nathanJarvis/RichArduino/Presentation/RichArduino.pptx

## RichArduino

By Jack Hyde, Nathan Jarvis, Dean Choi, Jabari Booker

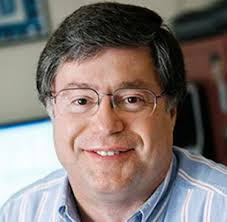
[picture p1: figure]
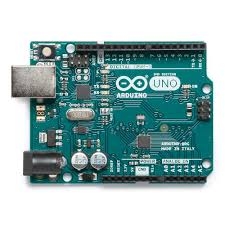
[picture p2: figure]

“

”

## Life Cycle of Program

“SMOP”

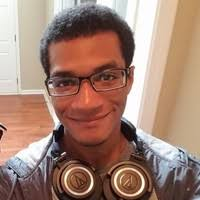
[picture p3: figure]

Compile

Assemble

Execute

.source

.asm

.bin

## Program Flow

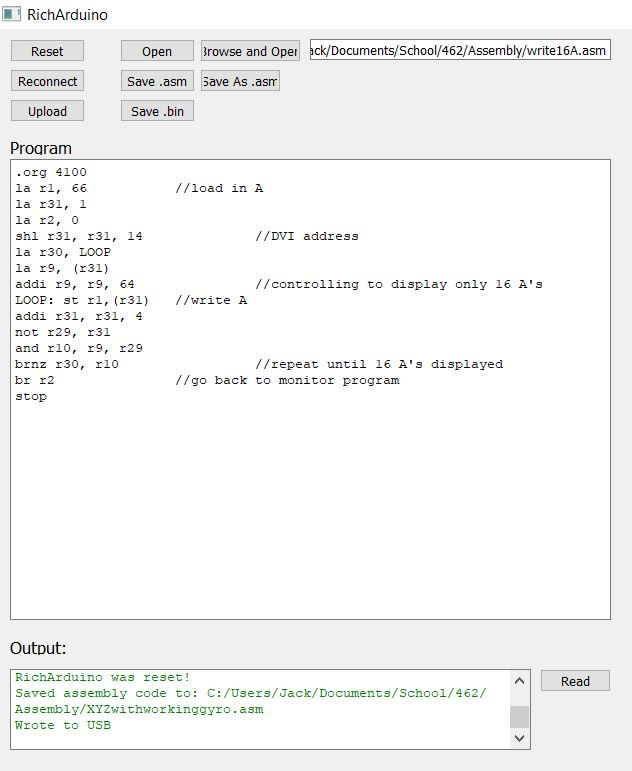
[picture p4: figure]
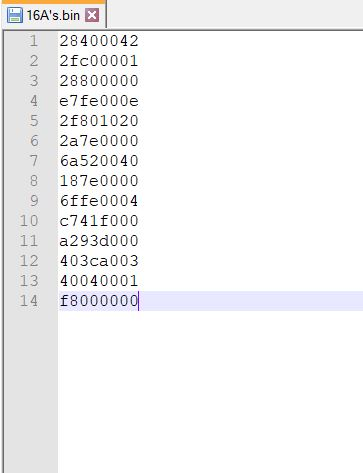
[picture p5: figure]

lots of work

Notes: When we actually run upload, prepends length and appends branch to address 0 which is the monitor program (more on this later)

## Slide 4

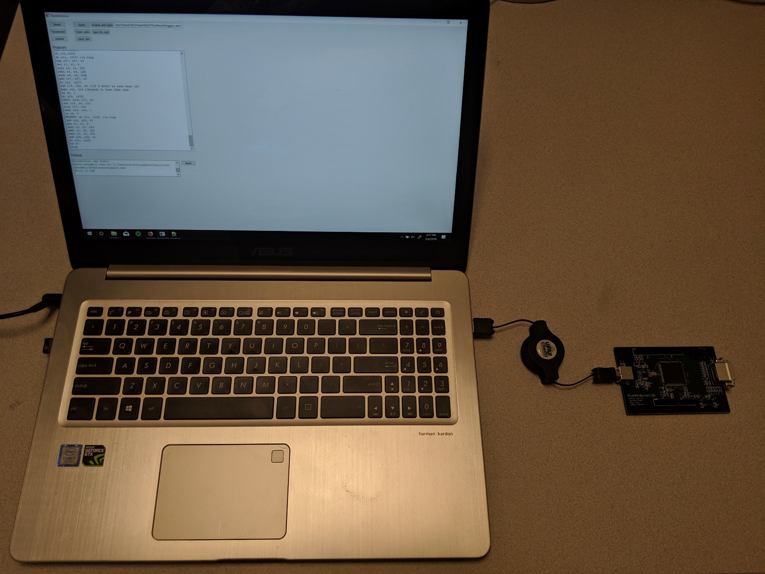
[picture p6: figure]

RichArduino

Host

GUI

FT201x

FPGA

FTDI Drivers

USB

I²C

## Slide 5

RichArduino

FPGA

RSRC

BUS

SRAM

FT201x

FIFO

I²C Slave

I²C

I²C Master

EEPROM

Notes: What are you downloading to?
Only subset of bus elts necessary for program downloading
I2C limited to byte reads so we need 4 reads
Procedure: RSRC running EEPROM code (monitor)
RSRC queries I2C Master which initiates an I2C transaction
First word sent is a length header.. Registered and decremented
I2C checks for four bytes, reads, RSRC decrements counter and stores full word to next address in SRAM

## Slide 6

RichArduino Peripherals

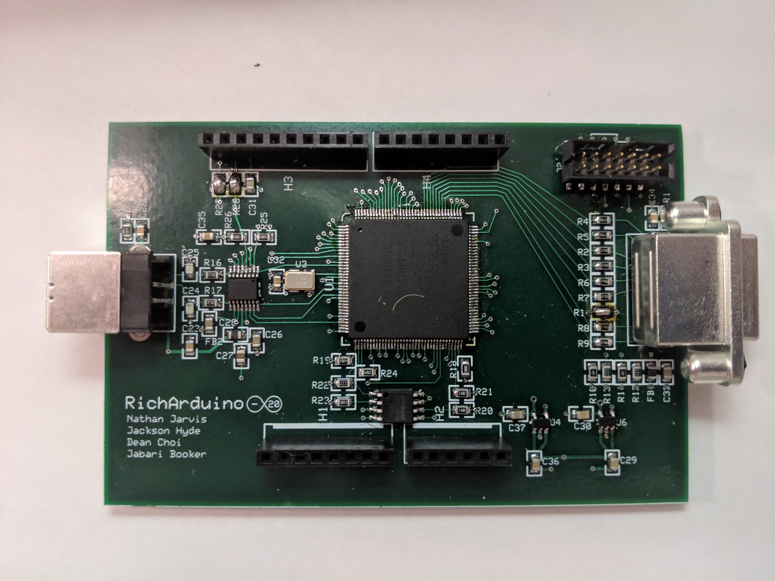
[picture p7: figure]

20 DIO

Headers for Arduino Shield

I²C

“HDMI”

Power

Notes: Once running, what do you have at your disposal?
Explain Shields
Explain 20 DIO’s (inout, DIO Manager)
Explain I2C shared with FT201x

## DEMO!
