nathanJarvis/RichArduino/VHDL and Monitor program/Monitor Program.rtf

la r31, LOOP //Loop address
la r7, LOOP2 //Loop2 address
la r25, LOOP3 //Loop3 for header checking
la r8, 3 //4byte count
la r17, 0 //program count
la r14, 0 //initialize header valid to 0
la r18, 0 //initialize header data to 0
la r30, 1
shl r30, r30, 13 //I2C address
la r1, 0 //register to store compared values
la r26, 1
shl r26, r26, 12 //Sram address that don't change
addi r26, r26, 4
la r27, 1
shl r27, r27, 12 //Sram address that change
LOOP: ld r1,(r30) //load valid bit
andi r2, r1, 1 //check valid bit
brzr r31, r2
ld r1, (r30) //read byte count
sub r2, r8, r1 //compare to 3
brpl r31, r2 //branch if >= 3
LOOP2: ld r1, 1(r30) //read valid bit
andi r2, r1, 1 //check valid bit
brzr r7, r2
ld r1, (r30) //read data
addi r18, r1, 0 //store data to r18
st r1, (r27) //store to Sram
addi r27, r27, 4
brzr r25, r14 //branch if no valid header
sub r17, r17, r14 //subtract 1 from program counter
brnz r31,r17 //keep reading if pc is not zero
br r26 //go to sram if pc is zero
LOOP3: la r14, 1 //valid header exist
addi r17, r18, 0 //loading valid header to r17
br r31 //branch back to beginning to read actual program
stop
