nathanJarvis/RichArduino/(list of files, drawings)

Other design files:
PCB and Schematic/richarduinoLayout.pcb
